wheuer/GeckoSmartWatch/README.md

# Gecko Smart Watch

This repository tracks the most recent state of my personal smart watch project.

It's a mess and unpolished. For a more in depth look at the project and it's history see [my website](https://www.williamfheuer.com/project-portfolio).
