wheuer/GeckoSmartWatch/Docs/images/gecko.png

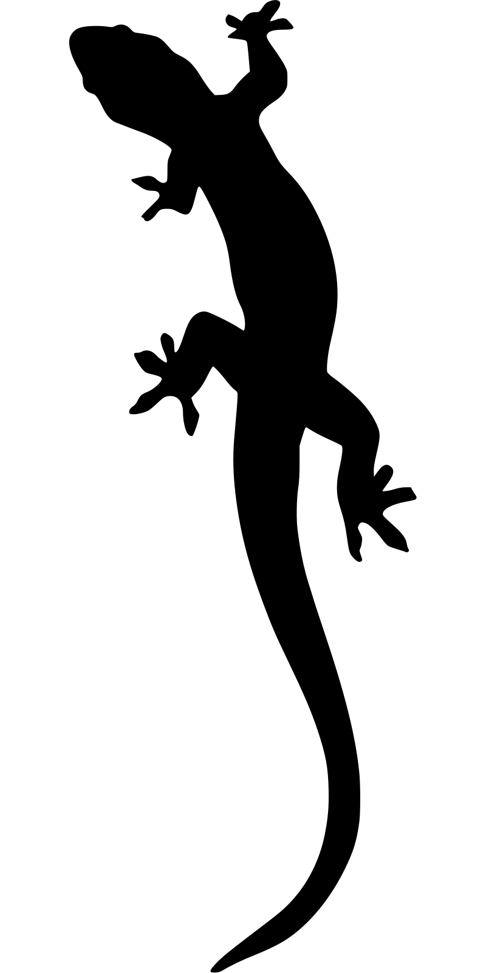
Docs/images/gecko.png
