wheuer/GeckoSmartWatch/Docs/images/Sloth_Tag.png

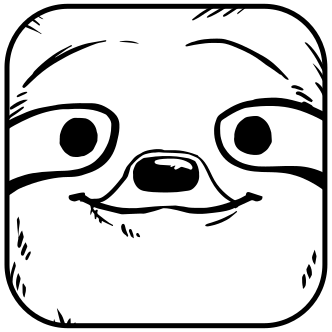
Docs/images/Sloth_Tag.png
