wheuer/GeckoSmartWatch/Software Tools/Display Visualizer/image.png

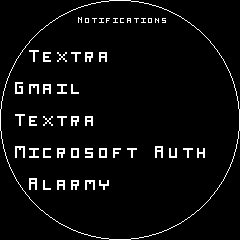
Software Tools/Display Visualizer/image.png
