wheuer/GeckoSmartWatch/KiCad/DevelopmentBoard/GeckoDevelopmentBoard.step

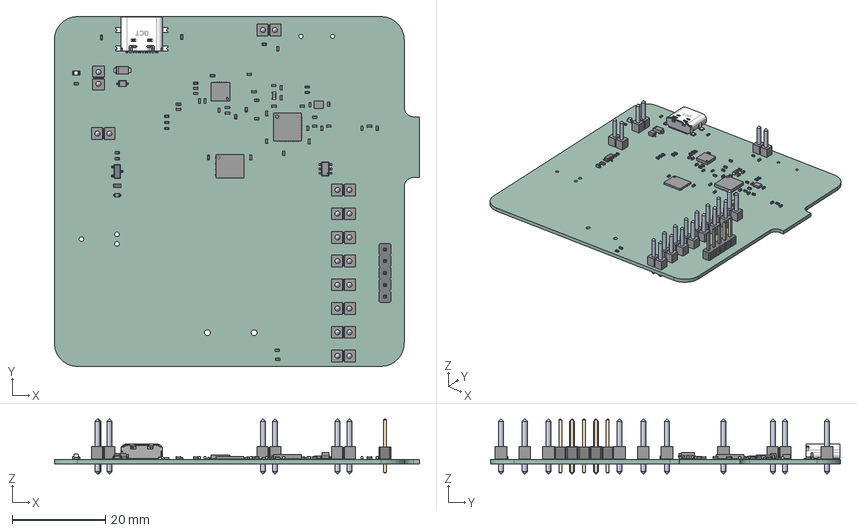
[picture p4: CAD file, 2024-07-24]
KiCad/DevelopmentBoard/GeckoDevelopmentBoard.step
78.3 x 75.0 x 11.7 mm
ASSEMBLY x 19
R_0603_1608Metric
C_0402_1005Metric x 30
SOT_23
LED_0603_1608Metric
PinHeader_1x05_P254mm_Vertical
R_0402_1005Metric x 17
L_0603_1608Metric
USB4110-GF-A
L_0402_1005Metric x 5
GeckoDevelopmentBoard_PCB
