wheuer/GeckoSmartWatch/KiCad/GeckoSmartWatch_V4_1/GeckoSmartWatch_V4_1.step

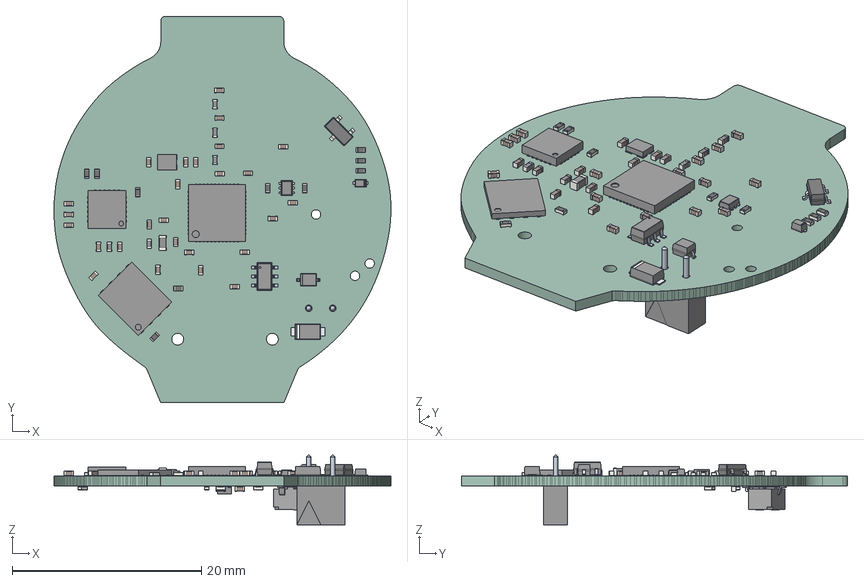
[picture p5: CAD file, 2024-09-02]
KiCad/GeckoSmartWatch_V4_1/GeckoSmartWatch_V4_1.step
35.6 x 40.9 x 7.37 mm
C_0402_1005Metric x 28
R_0402_1005Metric x 15
ASSEMBLY x 9
L_0402_1005Metric x 5
L_0603_1608Metric
DRL0006A_ASM
SOT_23
DSE0006A_ASM
CJS-1200TB
GeckoSmartWatch_V4_1_PCB
