wheuer/GeckoSmartWatch/KiCad/GeckoSmartWatch_V4_1/GeckoSmartWatch_V4_1.kicad_pcb

## KiCad design KiCad/GeckoSmartWatch_V4_1/GeckoSmartWatch_V4_1.kicad_pcb (2024-08-08)

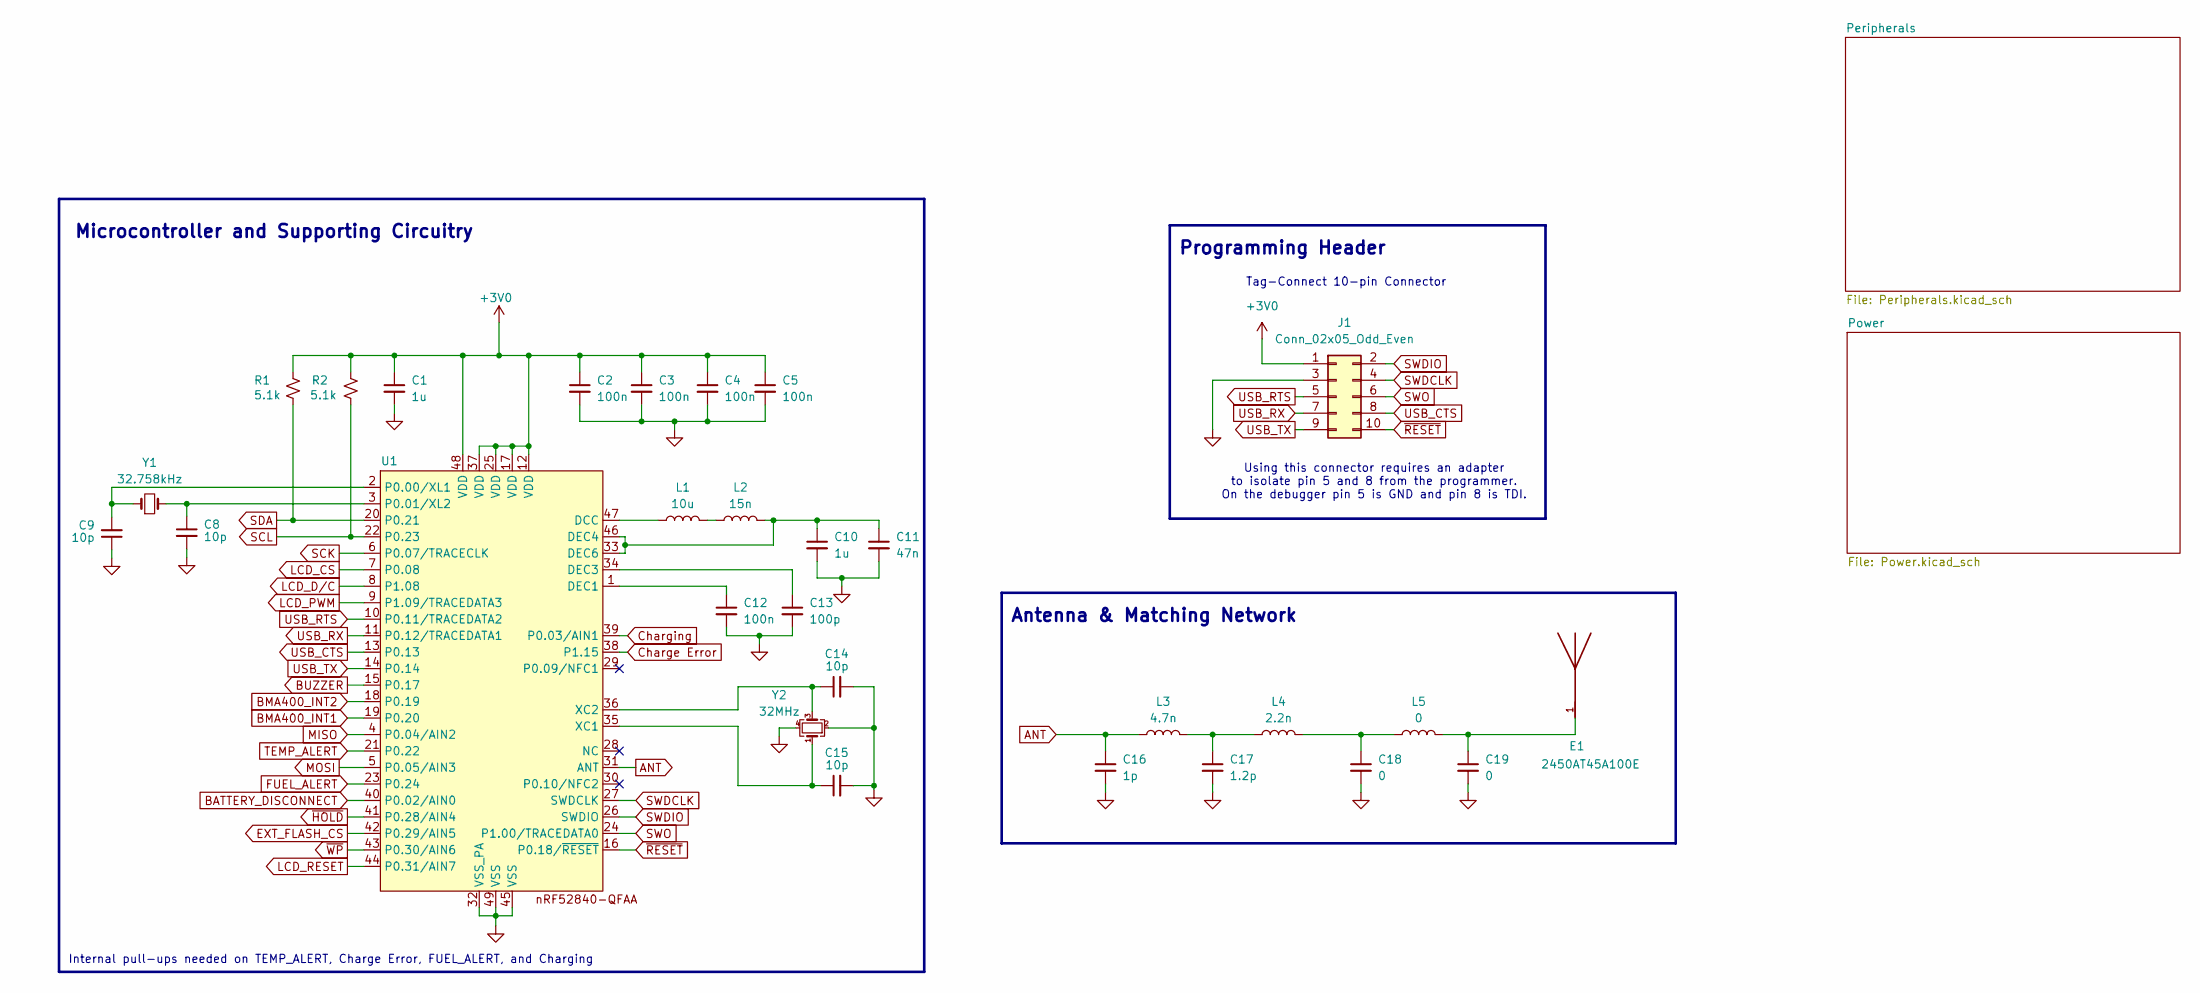
[picture p6: schematic GeckoSmartWatch_V4_1.kicad_sch]

Parts:
C1, C10: 1u; C_0402_1005Metric
C2, C3, C4, C5, C12: 100n; C_0402_1005Metric
C8, C9, C14, C15: 10p; C_0402_1005Metric
C11: 47n; C_0402_1005Metric
C13: 100p; C_0402_1005Metric
C16: 1p; C_0402_1005Metric
C17: 1.2p; C_0402_1005Metric
C18, C19: 0; C_0402_1005Metric
E1: 2450AT45A100E; ANT_2450AT45A100E; PARTREV 3.1
J1: Conn_02x05_Odd_Even; TAG-CONNECT_TC2050-IDC-NL
L1: 10u; L_0603_1608Metric
L2: 15n; L_0402_1005Metric
L3: 4.7n; L_0402_1005Metric
L4: 2.2n; L_0402_1005Metric
L5: 0; L_0402_1005Metric
R1, R2: 5.1k; R_0402_1005Metric
U1: nrf52840_QFN40P600X600X95-49N-D
Y1: 32.758kHz; 32kHz_ECS32712512RCTR
Y2: 32MHz; 32MHz_ECS320837CKMTR3

Connections:
+3V0: C1.1, C2.1, C3.1, C4.1, C5.1, J1.1, R1.2, R2.2, U1.12 (VDD), U1.17 (VDD), U1.25 (VDD), U1.37 (VDD), U1.48 (VDD); also elsewhere on the board
ANT: C16.1, L3.1, U1.31 (ANT)
BATTERY_DISCONNECT: U1.40 (P0.02/AIN0); also elsewhere on the board
BMA400_INT1: U1.19 (P0.20); also elsewhere on the board
BMA400_INT2: U1.18 (P0.19); also elsewhere on the board
BUZZER: U1.15 (P0.17); also elsewhere on the board
Charge Error: U1.38 (P1.15); also elsewhere on the board
Charging: U1.39 (P0.03/AIN1); also elsewhere on the board
EXT_FLASH_CS: U1.42 (P0.29/AIN5); also elsewhere on the board
FUEL_ALERT: U1.23 (P0.24); also elsewhere on the board
GND: C1.2, C2.2, C3.2, C4.2, C5.2, C8.2, C9.1, C10.2, C11.2, C12.2, C13.2, C14.2, C15.2, C16.2, C17.2, C18.2, C19.2, J1.3, U1.32 (VSS_PA), U1.45 (VSS), U1.49 (VSS), Y2.2, Y2.4; also elsewhere on the board
LCD_CS: U1.7 (P0.08); also elsewhere on the board
LCD_D/C: U1.8 (P1.08); also elsewhere on the board
LCD_PWM: U1.9 (P1.09/TRACEDATA3); also elsewhere on the board
LCD_RESET: U1.44 (P0.31/AIN7); also elsewhere on the board
MISO: U1.4 (P0.04/AIN2); also elsewhere on the board
MOSI: U1.5 (P0.05/AIN3); also elsewhere on the board
unnamed: C17.1, L3.2, L4.1
unnamed: C18.1, L4.2, L5.1
unnamed: C19.1, E1.1, L5.2
unnamed: L1.2, L2.1
unnamed: L1.1, U1.47 (DCC)
unnamed: C12.1, U1.1 (DEC1)
unnamed: C13.1, U1.34 (DEC3)
unnamed: C10.1, C11.1, L2.2, U1.33 (DEC6), U1.46 (DEC4)
unnamed: C9.2, U1.2 (P0.00/XL1), Y1.1
unnamed: C8.1, U1.3 (P0.01/XL2), Y1.2
unnamed: C15.1, U1.35 (XC1), Y2.1
unnamed: C14.1, U1.36 (XC2), Y2.3
SCK: U1.6 (P0.07/TRACECLK); also elsewhere on the board
SCL: R2.1, U1.22 (P0.23); also elsewhere on the board
SDA: R1.1, U1.20 (P0.21); also elsewhere on the board
SWDCLK: J1.4, U1.27 (SWDCLK)
SWDIO: J1.2, U1.26 (SWDIO)
SWO: J1.6, U1.24 (P1.00/TRACEDATA0)
TEMP_ALERT: U1.21 (P0.22); also elsewhere on the board
USB_CTS: J1.8, U1.13 (P0.13)
USB_RTS: J1.5, U1.10 (P0.11/TRACEDATA2)
USB_RX: J1.7, U1.11 (P0.12/TRACEDATA1)
USB_TX: J1.9, U1.14 (P0.14)
~HOLD: U1.41 (P0.28/AIN4); also elsewhere on the board
~RESET: J1.10, U1.16 (P0.18/~RESET)
~WP: U1.43 (P0.30/AIN6); also elsewhere on the board

Notes on the sheet:
Antenna & Matching Network
Using this connector requires an adapter to isolate pin 5 and 8 from the programmer. On the debugger pin 5 is GND and pin 8 is TDI.
Internal pull-ups needed on TEMP_ALERT, Charge Error, FUEL_ALERT, and Charging
Tag-Connect 10-pin Connector
Programming Header
Microcontroller and Supporting Circuitry

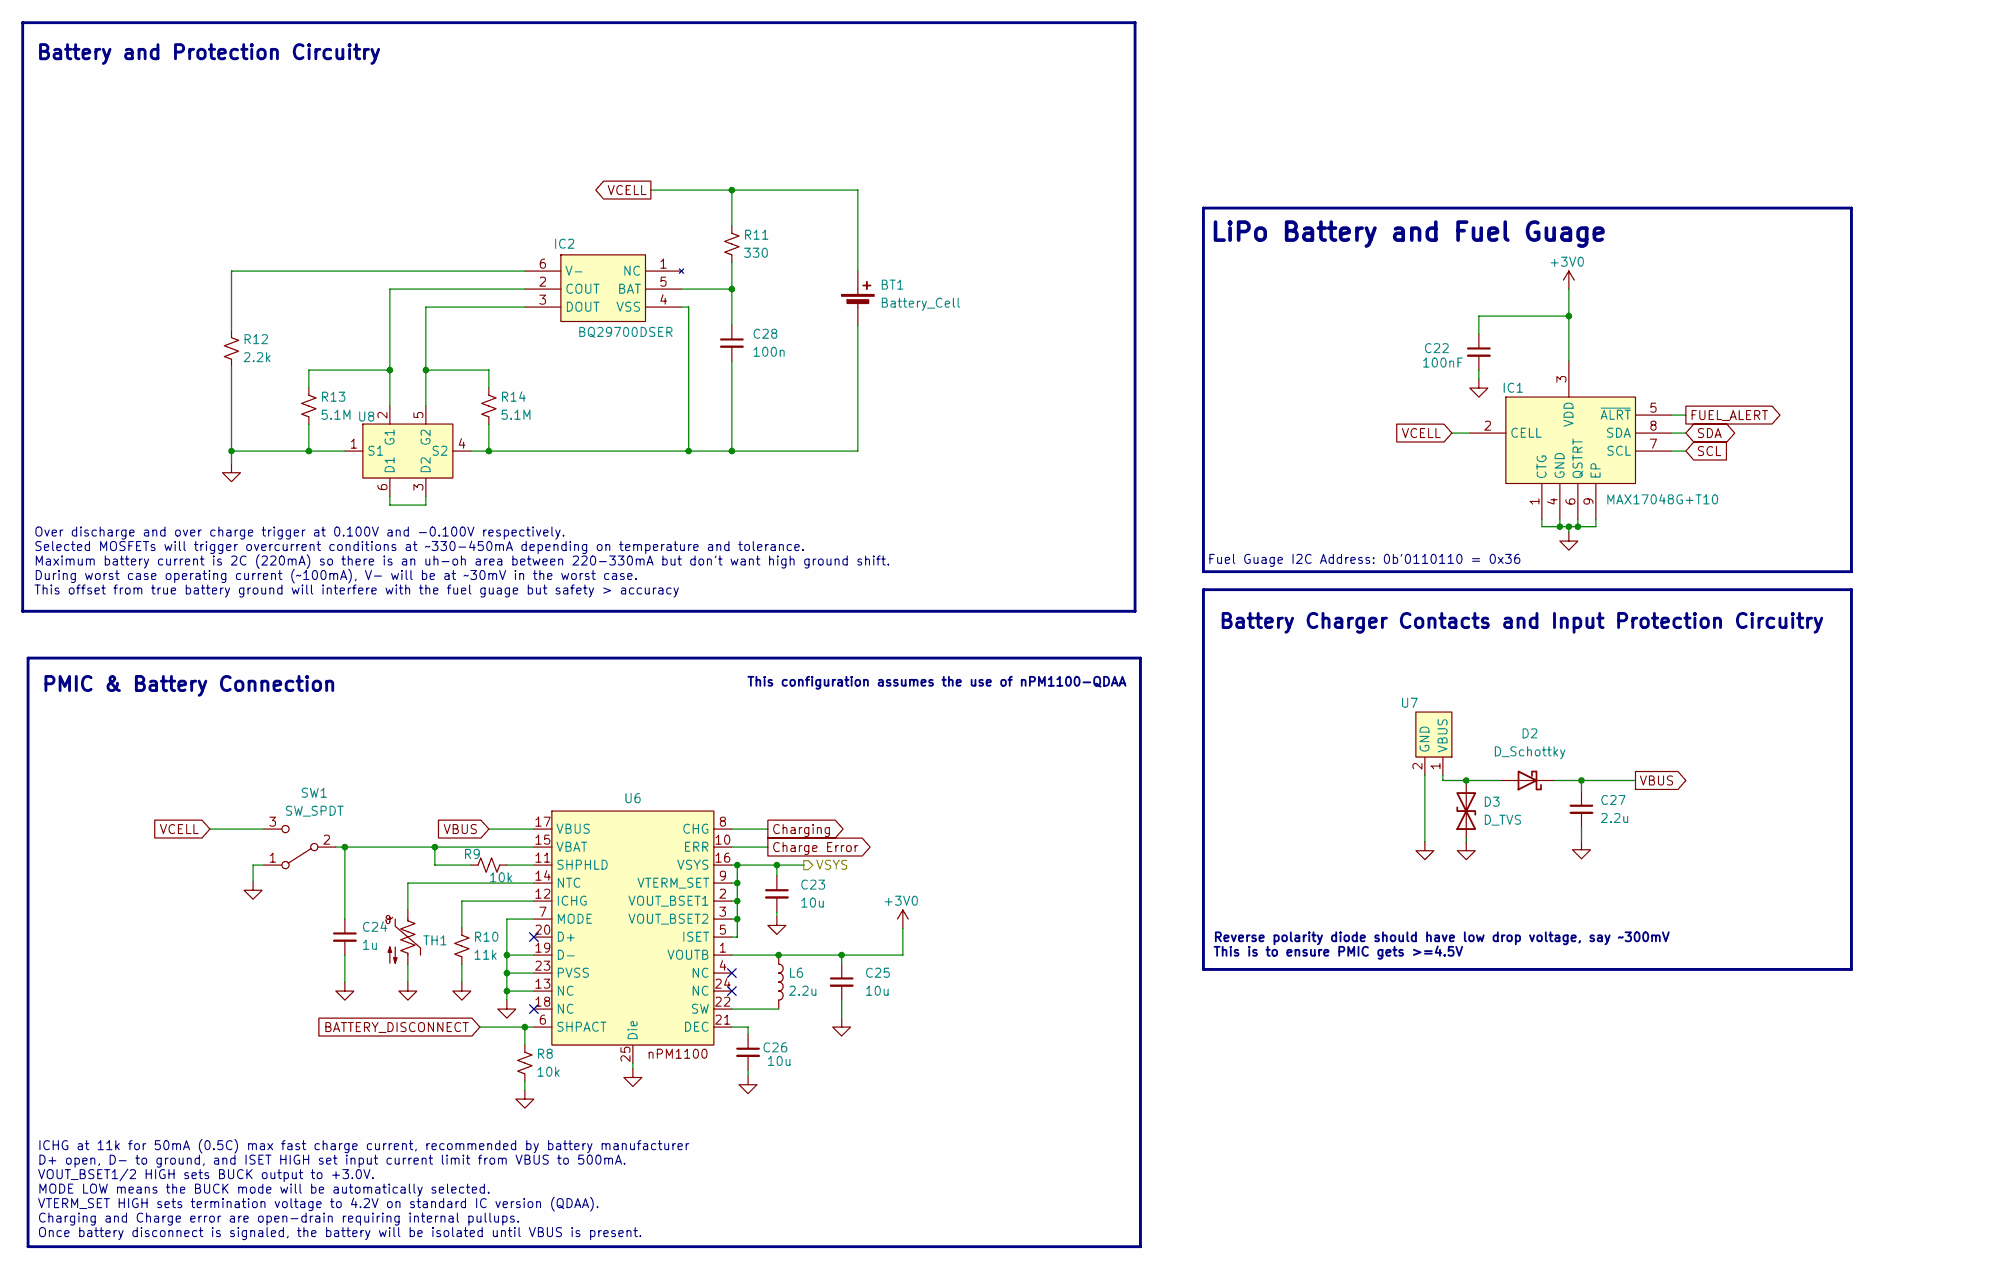
[picture p7: schematic Power.kicad_sch]

Parts:
BT1: Battery_Cell; RJD2430C1ST1
C22: 100nF; C_0402_1005Metric
C23, C25, C26: 10u; C_0402_1005Metric
C24: 1u; C_0402_1005Metric
C27: 2.2u; C_0402_1005Metric
C28: 100n; C_0402_1005Metric
D2: D_Schottky; reversePolarity_SODFL3616X98N
D3: D_TVS; TVS_SOD2513X120N
IC1: MAX17048G+T10; MAX17048_fuelGuague; Mouser Part Number 700-MAX17048G+T10
IC2: BQ29700DSER; batProtect_SON50P150X150X80-6N; Mouser Part Number 595-BQ29700DSER
L6: 2.2u; L_0402_1005Metric
R8, R9: 10k; R_0402_1005Metric
R10: 11k; R_0402_1005Metric
R11: 330; R_0402_1005Metric
R12: 2.2k; R_0402_1005Metric
R13, R14: 5.1M; R_0402_1005Metric
SW1: SW_SPDT; pwrSW_B-TYPE
TH1: Thermistor_NTC_US; R_0402_1005Metric
U6: nPM1100_QFN50P400X400X90-25N-D
U7: chargeContacts_RHDR2W51P0X254_1X2_508X254X419P
U8: batMOS_SOTFL95P280X88-6N

Connections:
+3V0: C22.1, C25.1, IC1.3 (VDD), L6.1, U6.1 (VOUTB); also elsewhere on the board
/Power/VSYS: C23.1, U6.2 (VOUT_BSET1), U6.3 (VOUT_BSET2), U6.5 (ISET), U6.9 (VTERM_SET), U6.16 (VSYS)
BATTERY_DISCONNECT: R8.1, U6.6 (SHPACT); also elsewhere on the board
Charge Error: U6.10 (ERR); also elsewhere on the board
Charging: U6.8 (CHG); also elsewhere on the board
FUEL_ALERT: IC1.5 (~ALRT); also elsewhere on the board
GND: C22.2, C23.2, C24.2, C25.2, C26.2, C27.2, D3.1 (A1), IC1.1 (CTG), IC1.4 (GND), IC1.6 (QSTRT), IC1.9 (EP), R8.2, R10.2, R12.2, R13.2, SW1.1 (A), TH1.2, U6.7 (MODE), U6.13 (NC), U6.19 (D-), U6.23 (PVSS), U6.25 (Die), U7.2 (GND), U8.1 (S1); also elsewhere on the board
unnamed: BT1.2 (-), C28.2, IC2.4 (VSS), R14.2, U8.4 (S2)
unnamed: D2.2 (A), D3.2 (A2), U7.1 (VBUS)
unnamed: C28.1, IC2.5 (BAT), R11.2
unnamed: IC2.2 (COUT), R13.1, U8.2 (G1)
unnamed: IC2.3 (DOUT), R14.1, U8.5 (G2)
unnamed: IC2.6 (V-), R12.1
unnamed: C24.1, R9.1, SW1.2 (B), U6.15 (VBAT)
unnamed: C26.1, U6.21 (DEC)
unnamed: R10.1, U6.12 (ICHG)
unnamed: TH1.1, U6.14 (NTC)
unnamed: R9.2, U6.11 (SHPHLD)
unnamed: L6.2, U6.22 (SW)
unnamed: U8.3 (D2), U8.6 (D1)
SCL: IC1.7 (SCL); also elsewhere on the board
SDA: IC1.8 (SDA); also elsewhere on the board
VBUS: C27.1, D2.1 (K), U6.17 (VBUS)
VCELL: BT1.1 (+), IC1.2 (CELL), R11.1, SW1.3 (C)

Notes on the sheet:
Battery and Protection Circuitry
Reverse polarity diode should have low drop voltage, say ~300mV This is to ensure PMIC gets >=4.5V
Over discharge and over charge trigger at 0.100V and -0.100V respectively. Selected MOSFETs will trigger overcurrent conditions at ~330-450mA depending on temperature and tolerance. Maximum battery current is 2C (220mA) so there is an uh-oh area between 220-330mA but don't want high ground shift. D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
This configuration assumes the use of nPM1100-QDAA
Battery Charger Contacts and Input Protection Circuitry
LiPo Battery and Fuel Guage
Fuel Guage I2C Address: 0b'0110110 = 0x36
PMIC & Battery Connection
ICHG at 11k for 50mA (0.5C) max fast charge current, recommended by battery manufacturer D+ open, D- to ground, and ISET HIGH set input current limit from VBUS to 500mA. VOUT_BSET1/2 HIGH sets BUCK output to +3.0V. MODE LOW means the BUCK mode will be automatically selected. VTERM_SET HIGH sets ter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

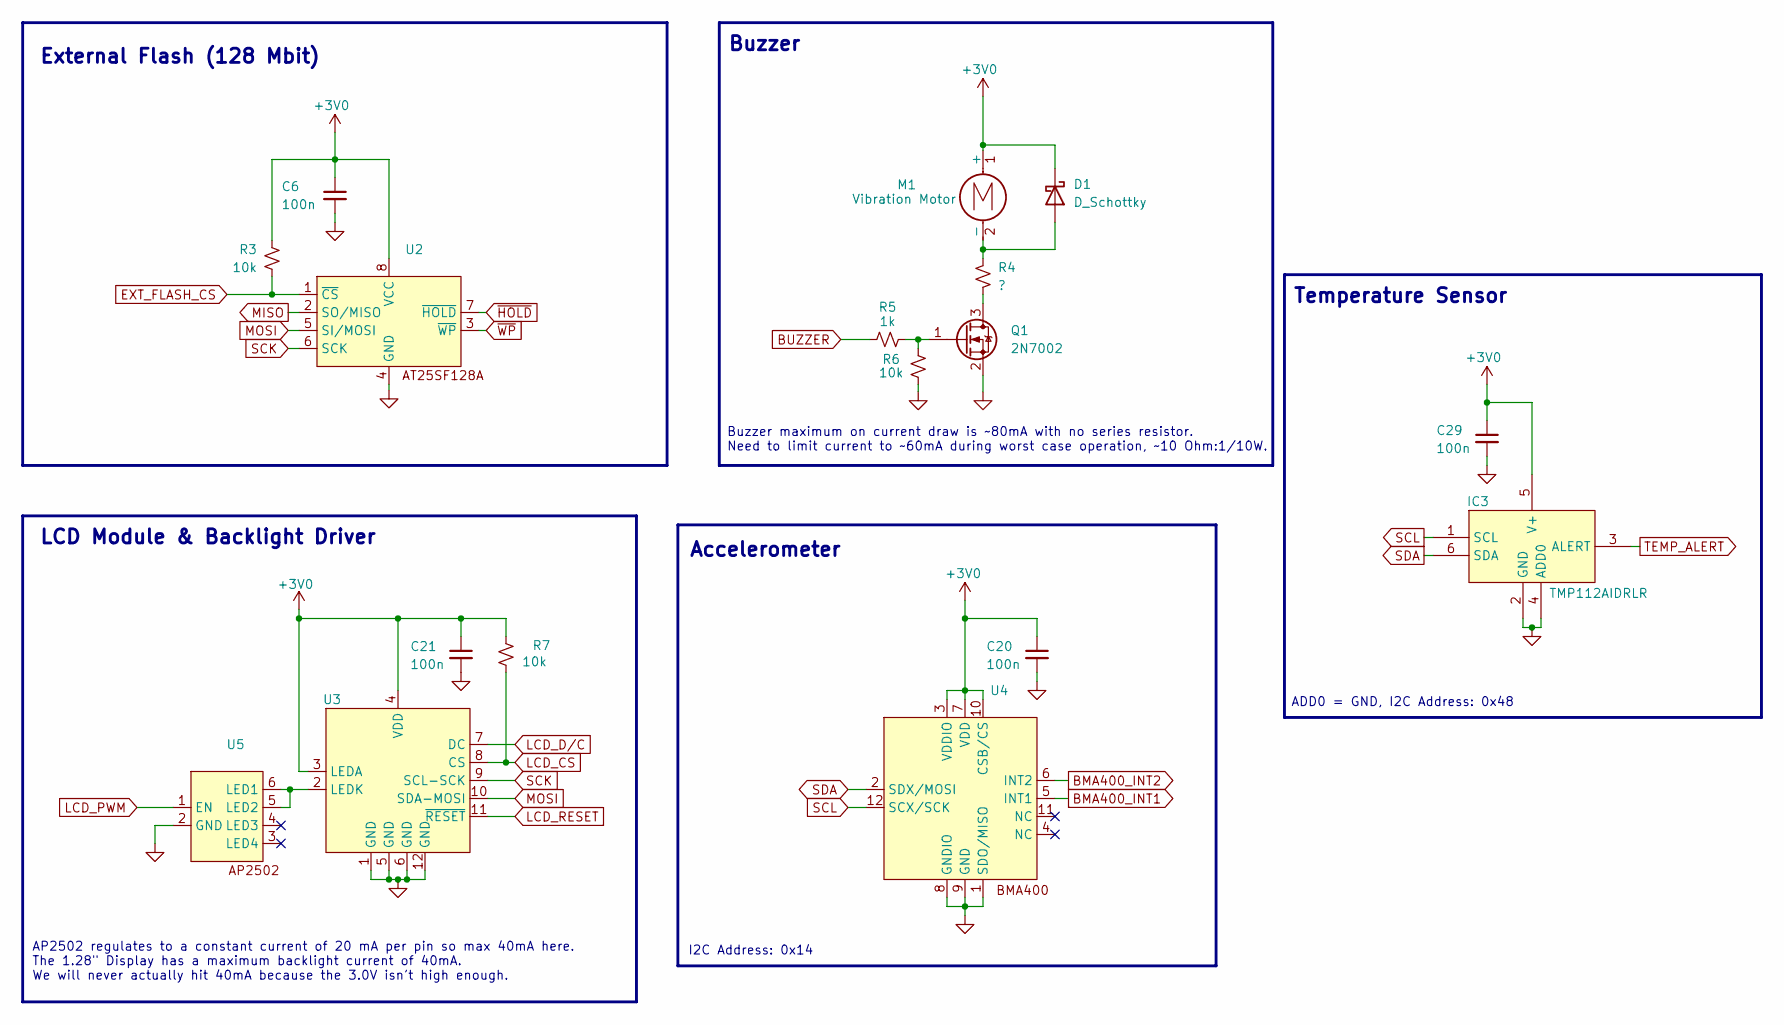
[picture p8: schematic Peripherals.kicad_sch]

Parts:
C6, C20, C21, C29: 100n; C_0402_1005Metric
D1: D_Schottky; flyback_SODFL1608X70N
IC3: TMP112AIDRLR; tmp_SOTFL50P160X60-6N; Mouser Part Number 595-TMP112AIDRLR
M1: Vibration Motor; SMD_vibrationMotor
Q1: 2N7002; SOT-23
R3, R6, R7: 10k; R_0402_1005Metric
R4: ?; R_0402_1005Metric
R5: 1k; R_0402_1005Metric
U2: extFlash_SON127P600X500X60-9N-D
U3: 1.47_TFT_displayConnector
U4: BOSCH_LGA_12
U5: AP2502_SOT95P280X145-6N

Connections:
+3V0: C6.1, C20.1, C21.1, C29.1, D1.1 (K), IC3.5 (V+), M1.1 (+), R3.1, R7.1, U2.8 (VCC), U3.3 (LEDA), U3.4 (VDD), U4.3 (VDDIO), U4.7 (VDD), U4.10 (CSB/CS); also elsewhere on the board
BMA400_INT1: U4.5 (INT1); also elsewhere on the board
BMA400_INT2: U4.6 (INT2); also elsewhere on the board
BUZZER: R5.1; also elsewhere on the board
EXT_FLASH_CS: R3.2, U2.1 (~CS); also elsewhere on the board
GND: C6.2, C20.2, C21.2, C29.2, IC3.2 (GND), IC3.4 (ADD0), Q1.2 (S), R6.1, U2.4 (GND), U3.1 (GND), U3.5 (GND), U3.6 (GND), U3.12 (GND), U4.1 (SDO/MISO), U4.8 (GNDIO), U4.9 (GND), U5.2 (GND); also elsewhere on the board
LCD_CS: R7.2, U3.8 (CS); also elsewhere on the board
LCD_D/C: U3.7 (DC); also elsewhere on the board
LCD_PWM: U5.1 (EN); also elsewhere on the board
LCD_RESET: U3.11 (~RESET); also elsewhere on the board
MISO: U2.2 (SO/MISO); also elsewhere on the board
MOSI: U2.5 (SI/MOSI), U3.10 (SDA-MOSI); also elsewhere on the board
unnamed: D1.2 (A), M1.2 (-), R4.1
unnamed: Q1.3 (D), R4.2
unnamed: Q1.1 (G), R5.2, R6.2
unnamed: U3.2 (LEDK), U5.5 (LED2), U5.6 (LED1)
SCK: U2.6 (SCK), U3.9 (SCL-SCK); also elsewhere on the board
SCL: IC3.1 (SCL), U4.12 (SCX/SCK); also elsewhere on the board
SDA: IC3.6 (SDA), U4.2 (SDX/MOSI); also elsewhere on the board
TEMP_ALERT: IC3.3 (ALERT); also elsewhere on the board
~HOLD: U2.7 (~HOLD); also elsewhere on the board
~WP: U2.3 (~WP); also elsewhere on the board

Notes on the sheet:
Buzzer
I2C Address: 0x14
ADD0 = GND, I2C Address: 0x48
AP2502 regulates to a constant current of 20 mA per pin so max 40mA here. The 1.28" Display has a maximum backlight current of 40mA. We will never actually hit 40mA because the 3.0V isn't high enough.
Buzzer maximum on current draw is ~80mA with no series resistor. Need to limit current to ~60mA during worst case operation, ~10 Ohm:1/10W.
Temperature Sensor
External Flash (128 Mbit)
LCD Module & Backlight Driver
Accelerometer

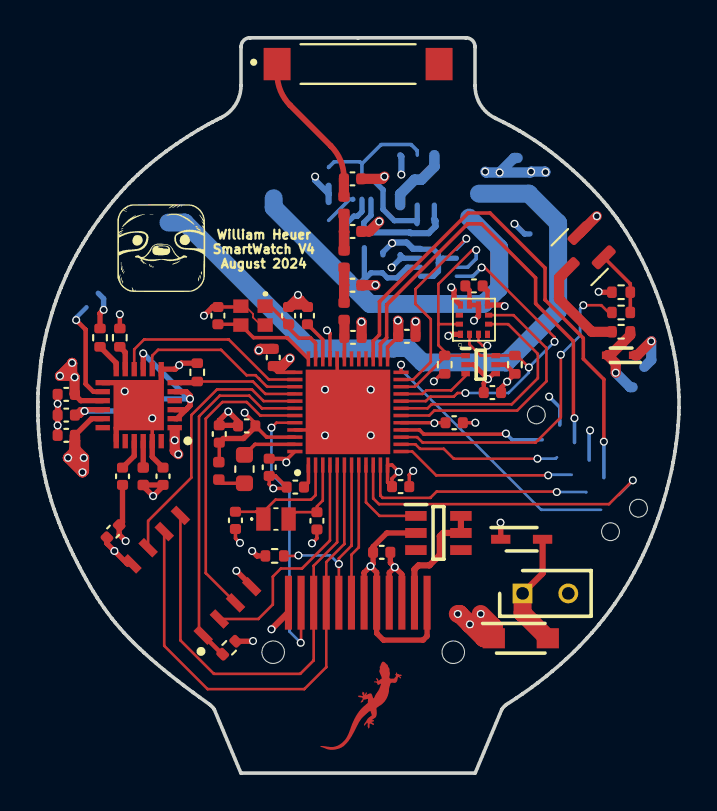
[picture p9: board GeckoSmartWatch_V4_1.kicad_pcb from above]

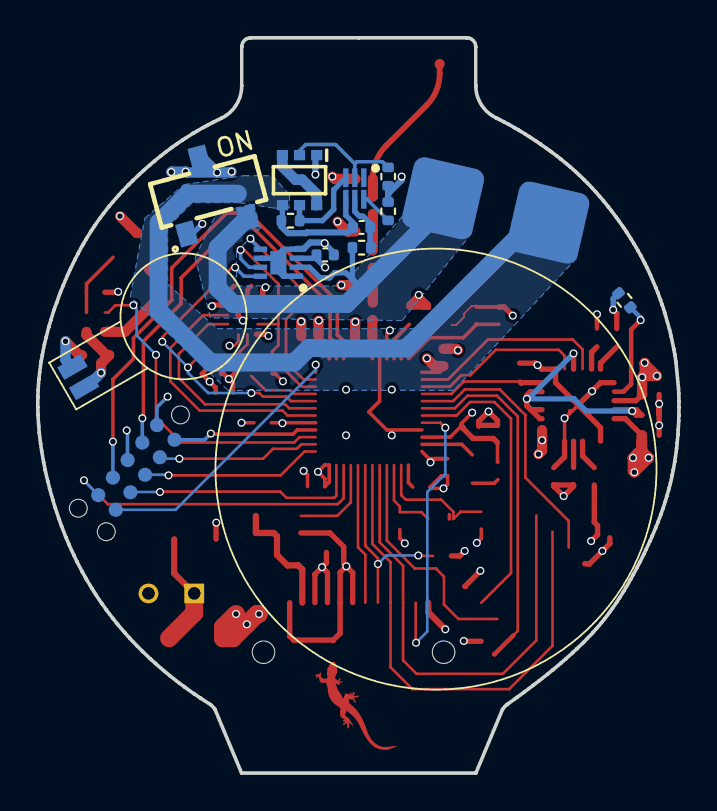
[picture p10: board GeckoSmartWatch_V4_1.kicad_pcb from below]

Board: 4 copper layers, 35.6 x 40.9 mm, 71 parts (14 on the bottom side), 63 nets.
