wheuer/GeckoSmartWatch/KiCad/TagConnectAdapter/TagConnectAdapter.kicad_pcb

## KiCad design KiCad/TagConnectAdapter/TagConnectAdapter.kicad_pcb (2024-07-24)

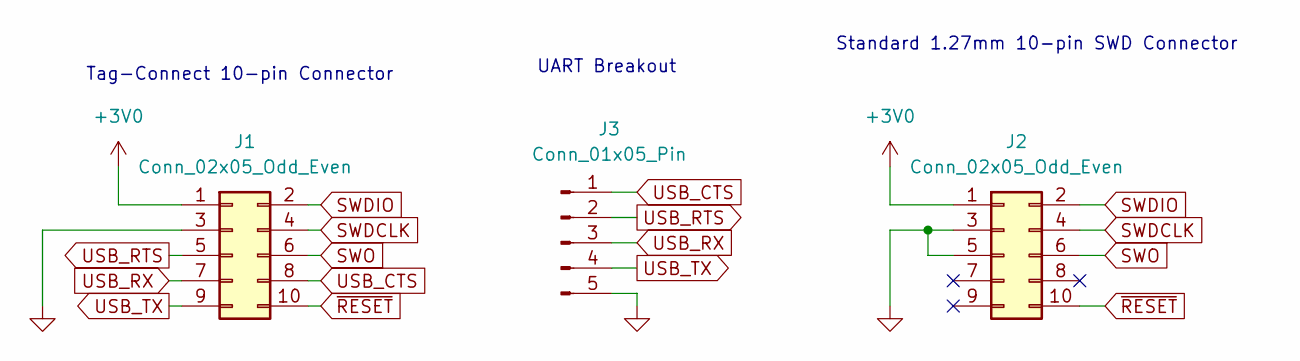
[picture p11: schematic TagConnectAdapter.kicad_sch]

Parts:
J1: Conn_02x05_Odd_Even; CNC_TECH_1.27mm_10-pin
J2: Conn_02x05_Odd_Even; AMPHENOL_20021311-00010T4LF
J3: Conn_01x05_Pin; PinSocket_1x05_P2.54mm_Vertical

Connections:
+3V0: J1.1, J2.1
GND: J1.3, J2.3, J2.5, J3.5
SWDCLK: J1.4, J2.4
SWDIO: J1.2, J2.2
SWO: J1.6, J2.6
USB_CTS: J1.8, J3.1
USB_RTS: J1.5, J3.2
USB_RX: J1.7, J3.3
USB_TX: J1.9, J3.4
~RESET: J1.10, J2.10

Notes on the sheet:
Standard 1.27mm 10-pin SWD Connector
UART Breakout
Tag-Connect 10-pin Connector

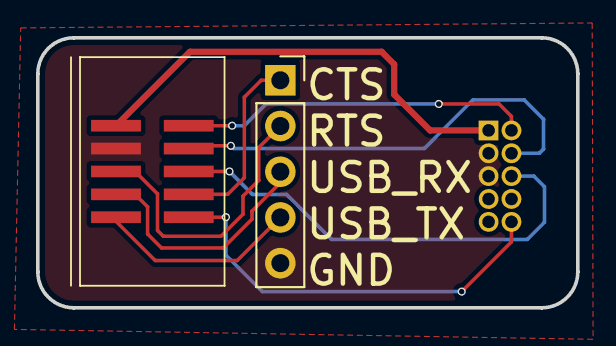
[picture p12: board TagConnectAdapter.kicad_pcb from above]

Board: 2 copper layers, 30.0 x 15.0 mm, 3 parts (1 on the bottom side), 10 nets.
