wheuer/GeckoSmartWatch/KiCad/DevelopmentBoard/GeckoDevelopmentBoard.kicad_pcb

## KiCad design KiCad/DevelopmentBoard/GeckoDevelopmentBoard.kicad_pcb (2024-07-24)

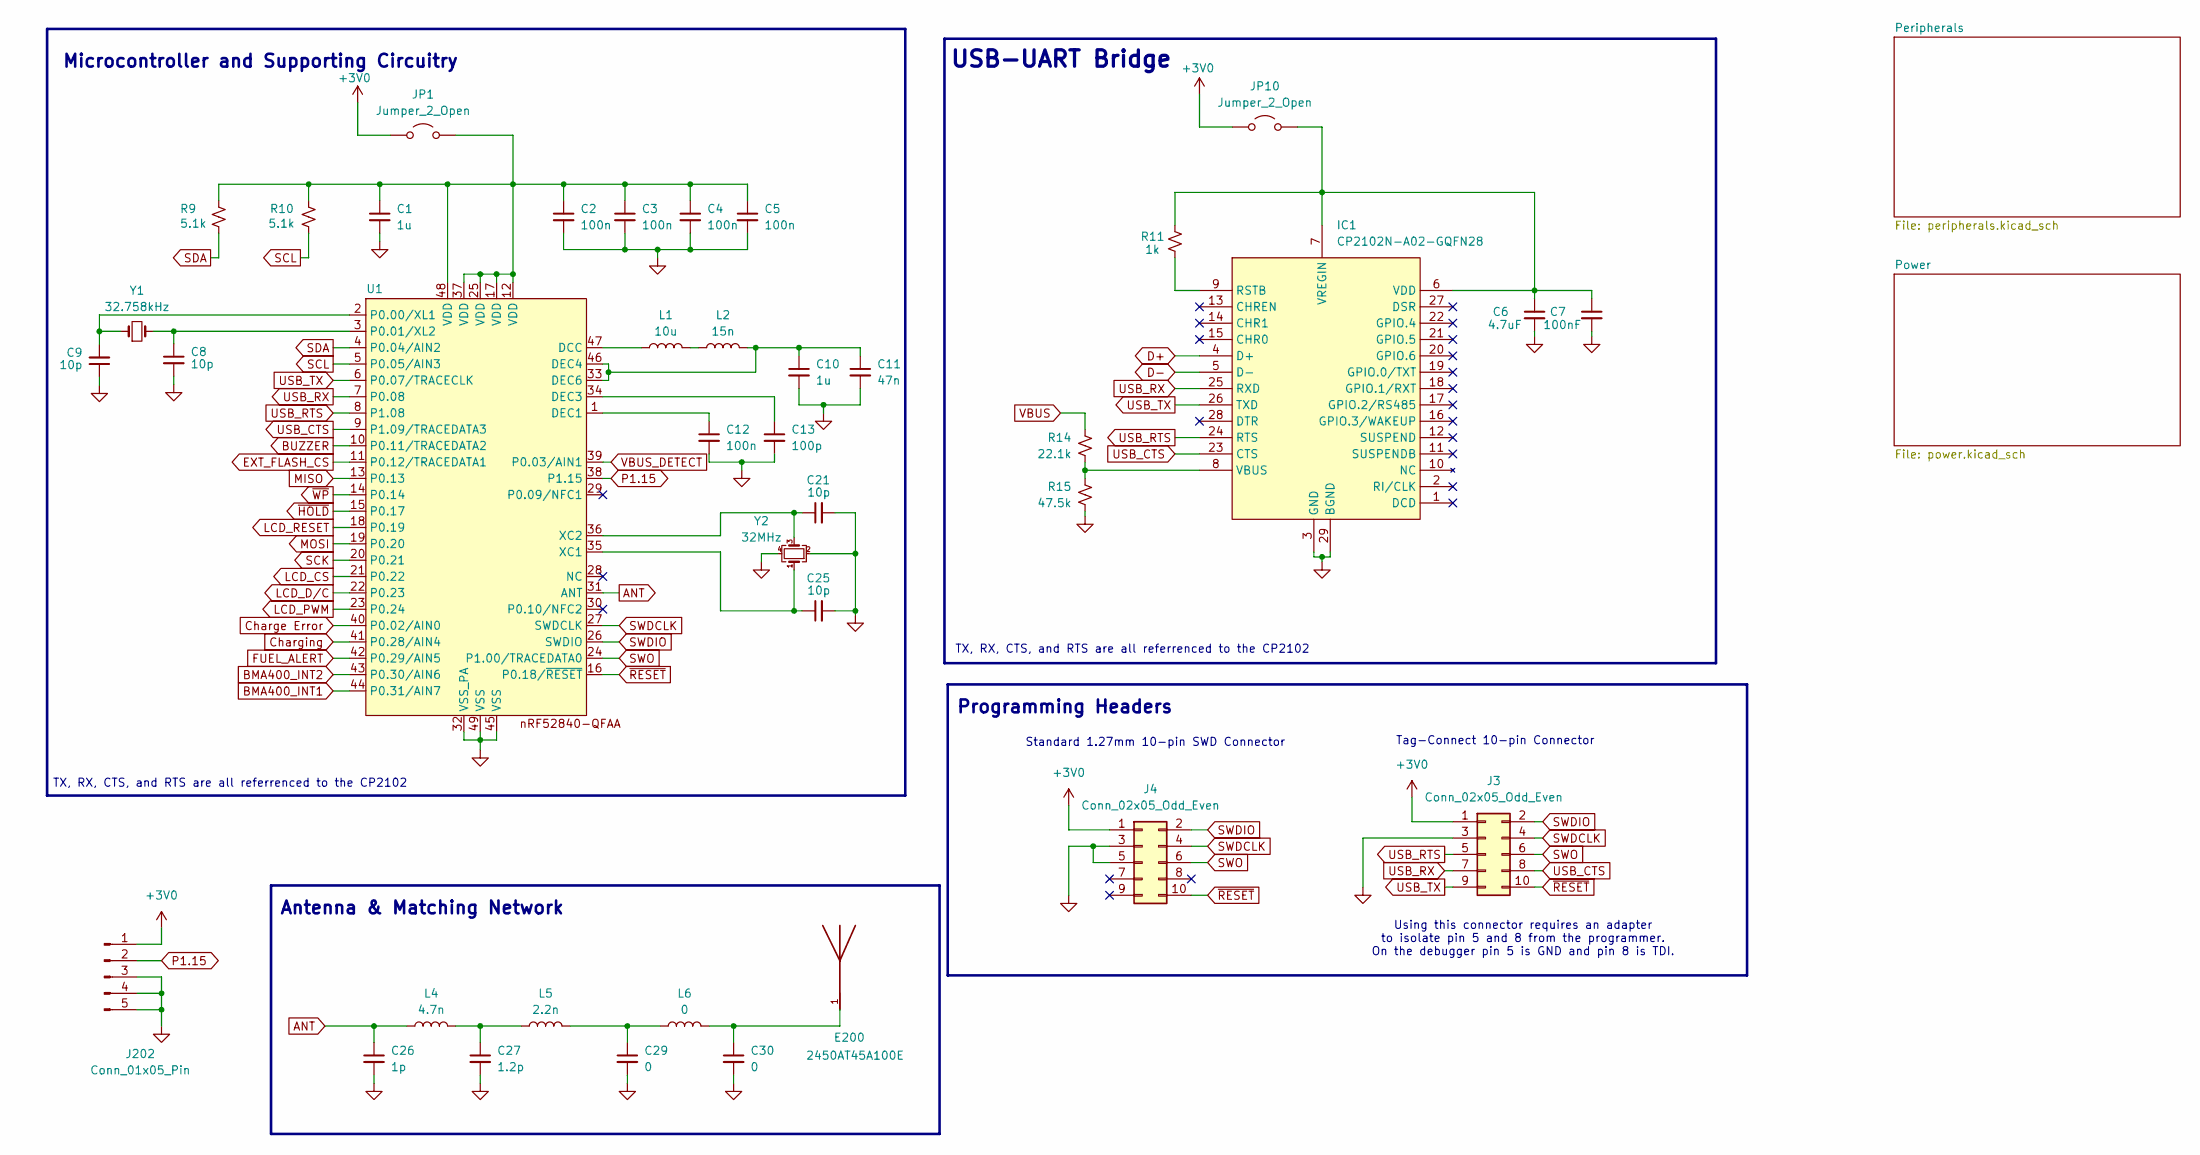
[picture p13: schematic GeckoDevelopmentBoard.kicad_sch]

Parts:
C1, C10: 1u; C_0402_1005Metric
C2, C3, C4, C5, C12: 100n; C_0402_1005Metric
C6: 4.7uF; C_0402_1005Metric
C7: 100nF; C_0402_1005Metric
C8, C9, C21, C25: 10p; C_0402_1005Metric
C11: 47n; C_0402_1005Metric
C13: 100p; C_0402_1005Metric
C26: 1p; C_0402_1005Metric
C27: 1.2p; C_0402_1005Metric
C29, C30: 0; C_0402_1005Metric
E200: 2450AT45A100E; ANT_2450AT45A100E; PARTREV 3.1
IC1: CP2102N-A02-GQFN28; CP2102_5x5QFN; Mouser Part Number 634-CP2102NA02GQFN28
J3: Conn_02x05_Odd_Even; TAG-CONNECT_TC2050-IDC-NL
J4: Conn_02x05_Odd_Even; CNC_TECH_1.27mm_10-pin
J202: Conn_01x05_Pin; PinHeader_1x05_P2.54mm_Vertical
JP1, JP10: Jumper_2_Open; 2pinJumper_HDRV2W110P0X254_1X2_508X254X854P
L1: 10u; L_0603_1608Metric
L2: 15n; L_0402_1005Metric
L4: 4.7n; L_0402_1005Metric
L5: 2.2n; L_0402_1005Metric
L6: 0; L_0402_1005Metric
R9, R10: 5.1k; R_0402_1005Metric
R11: 1k; R_0402_1005Metric
R14: 22.1k; R_0402_1005Metric
R15: 47.5k; R_0402_1005Metric
U1: nrf52840_QFN40P600X600X95-49N-D
Y1: 32.758kHz; 32kHz_ECS32712512RCTR
Y2: 32MHz; 32MHz_ECS320837CKMTR3

Connections:
+3V0: J3.1, J4.1, J202.1, JP1.1 (A), JP10.1 (A); also elsewhere on the board
ANT: C26.1, L4.1, U1.31 (ANT)
BMA400_INT1: U1.44 (P0.31/AIN7); also elsewhere on the board
BMA400_INT2: U1.43 (P0.30/AIN6); also elsewhere on the board
BUZZER: U1.10 (P0.11/TRACEDATA2); also elsewhere on the board
Charge Error: U1.40 (P0.02/AIN0); also elsewhere on the board
Charging: U1.41 (P0.28/AIN4); also elsewhere on the board
D+: IC1.4 (D+); also elsewhere on the board
D-: IC1.5 (D-); also elsewhere on the board
EXT_FLASH_CS: U1.11 (P0.12/TRACEDATA1); also elsewhere on the board
FUEL_ALERT: U1.42 (P0.29/AIN5); also elsewhere on the board
GND: C1.2, C2.2, C3.2, C4.2, C5.2, C6.2, C7.2, C8.2, C9.1, C10.2, C11.2, C12.2, C13.2, C21.2, C25.2, C26.2, C27.2, C29.2, C30.2, IC1.3 (GND), IC1.29 (BGND), J3.3, J4.3, J4.5, J202.3, J202.4, J202.5, R15.2, U1.32 (VSS_PA), U1.45 (VSS), U1.49 (VSS), Y2.2, Y2.4; also elsewhere on the board
LCD_CS: U1.21 (P0.22); also elsewhere on the board
LCD_D/C: U1.22 (P0.23); also elsewhere on the board
LCD_PWM: U1.23 (P0.24); also elsewhere on the board
LCD_RESET: U1.18 (P0.19); also elsewhere on the board
MISO: U1.13 (P0.13); also elsewhere on the board
MOSI: U1.19 (P0.20); also elsewhere on the board
unnamed: C27.1, L4.2, L5.1
unnamed: C29.1, L5.2, L6.1
unnamed: C30.1, E200.1, L6.2
unnamed: IC1.9 (RSTB), R11.2
unnamed: IC1.8 (VBUS), R14.2, R15.1
unnamed: C6.1, C7.1, IC1.6 (VDD), IC1.7 (VREGIN), JP10.2 (B), R11.1
unnamed: C1.1, C2.1, C3.1, C4.1, C5.1, JP1.2 (B), R9.2, R10.2, U1.12 (VDD), U1.17 (VDD), U1.25 (VDD), U1.37 (VDD), U1.48 (VDD)
unnamed: L1.2, L2.1
unnamed: L1.1, U1.47 (DCC)
unnamed: C12.1, U1.1 (DEC1)
unnamed: C13.1, U1.34 (DEC3)
unnamed: C10.1, C11.1, L2.2, U1.33 (DEC6), U1.46 (DEC4)
unnamed: C9.2, U1.2 (P0.00/XL1), Y1.1
unnamed: C8.1, U1.3 (P0.01/XL2), Y1.2
unnamed: C25.1, U1.35 (XC1), Y2.1
unnamed: C21.1, U1.36 (XC2), Y2.3
P1.15: J202.2, U1.38 (P1.15)
SCK: U1.20 (P0.21); also elsewhere on the board
SCL: R10.1, U1.5 (P0.05/AIN3); also elsewhere on the board
SDA: R9.1, U1.4 (P0.04/AIN2); also elsewhere on the board
SWDCLK: J3.4, J4.4, U1.27 (SWDCLK)
SWDIO: J3.2, J4.2, U1.26 (SWDIO)
SWO: J3.6, J4.6, U1.24 (P1.00/TRACEDATA0)
USB_CTS: IC1.23 (CTS), J3.8, U1.9 (P1.09/TRACEDATA3)
USB_RTS: IC1.24 (RTS), J3.5, U1.8 (P1.08)
USB_RX: IC1.25 (RXD), J3.7, U1.7 (P0.08)
USB_TX: IC1.26 (TXD), J3.9, U1.6 (P0.07/TRACECLK)
VBUS: R14.1; also elsewhere on the board
VBUS_DETECT: U1.39 (P0.03/AIN1); also elsewhere on the board
~HOLD: U1.15 (P0.17); also elsewhere on the board
~RESET: J3.10, J4.10, U1.16 (P0.18/~RESET)
~WP: U1.14 (P0.14); also elsewhere on the board

Notes on the sheet:
USB-UART Bridge
TX, RX, CTS, and RTS are all referrenced to the CP2102
Tag-Connect 10-pin Connector
Antenna & Matching Network
Programming Headers
Standard 1.27mm 10-pin SWD Connector
Microcontroller and Supporting Circuitry
Using this connector requires an adapter to isolate pin 5 and 8 from the programmer. On the debugger pin 5 is GND and pin 8 is TDI.

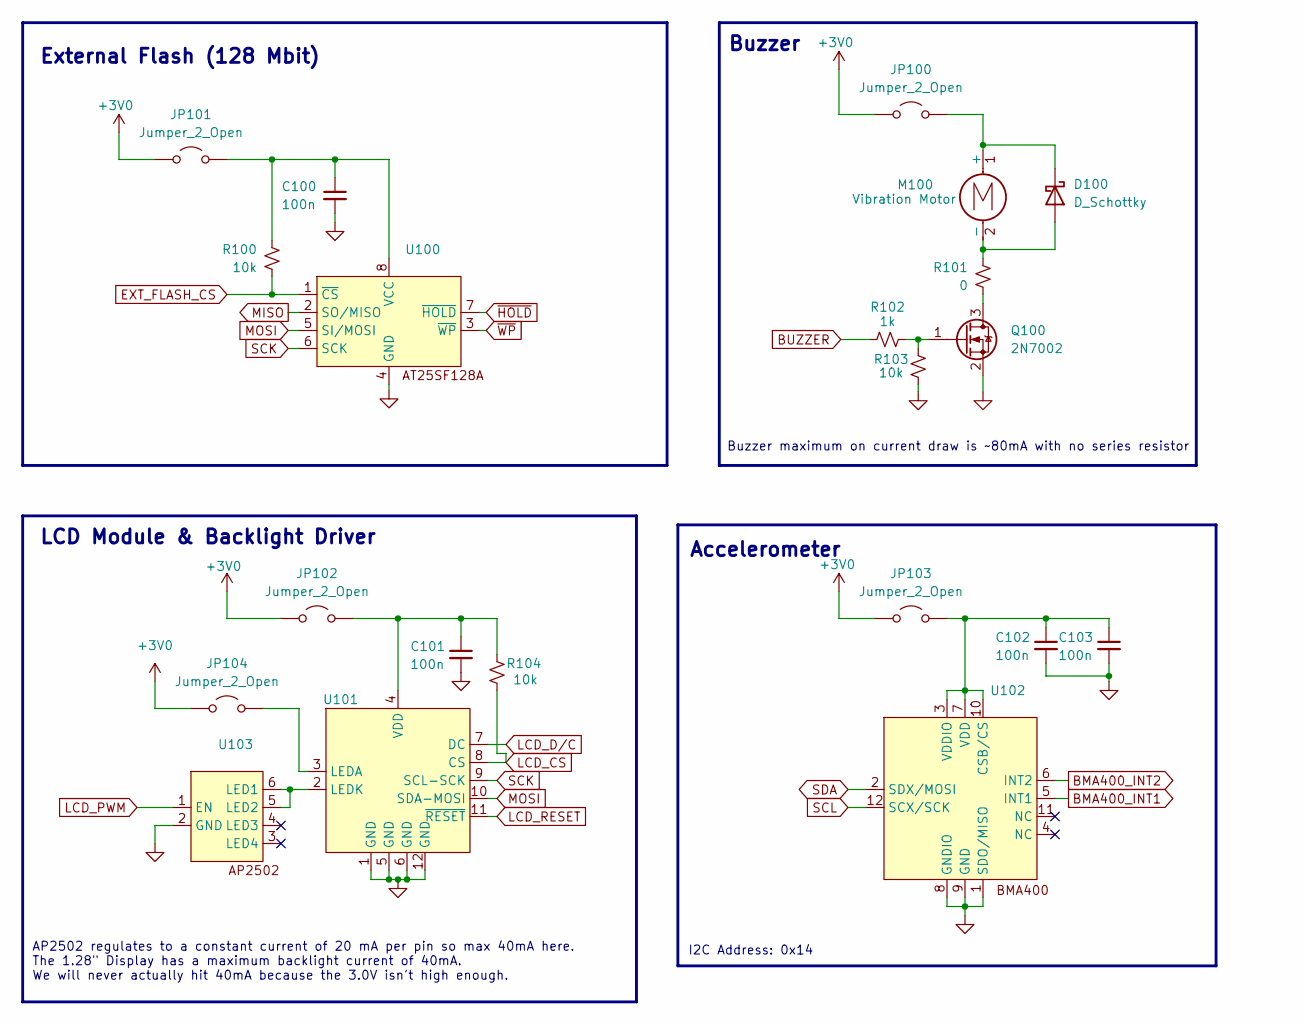
[picture p14: schematic peripherals.kicad_sch]

Parts:
C100, C101, C102, C103: 100n; C_0402_1005Metric
D100: D_Schottky; flyback_SODFL1608X70N
JP100, JP101, JP102, JP103, JP104: Jumper_2_Open; 2pinJumper_HDRV2W110P0X254_1X2_508X254X854P
M100: Vibration Motor; SMD_vibrationMotor
Q100: 2N7002; SOT-23
R100, R103, R104: 10k; R_0402_1005Metric
R101: 0; R_0603_1608Metric
R102: 1k; R_0402_1005Metric
U100: extFlash_SON127P600X500X60-9N-D
U101: 1.47_TFT_displayConnector
U102: BOSCH_LGA_12
U103: AP2502_SOT95P280X145-6N

Connections:
+3V0: JP100.1 (A), JP101.1 (A), JP102.1 (A), JP103.1 (A), JP104.1 (A); also elsewhere on the board
BMA400_INT1: U102.5 (INT1); also elsewhere on the board
BMA400_INT2: U102.6 (INT2); also elsewhere on the board
BUZZER: R102.1; also elsewhere on the board
EXT_FLASH_CS: R100.2, U100.1 (~CS); also elsewhere on the board
GND: C100.2, C101.2, C102.2, C103.2, Q100.2 (S), R103.1, U100.4 (GND), U101.1 (GND), U101.5 (GND), U101.6 (GND), U101.12 (GND), U102.1 (SDO/MISO), U102.8 (GNDIO), U102.9 (GND), U103.2 (GND); also elsewhere on the board
LCD_CS: R104.2, U101.8 (CS); also elsewhere on the board
LCD_D/C: U101.7 (DC); also elsewhere on the board
LCD_PWM: U103.1 (EN); also elsewhere on the board
LCD_RESET: U101.11 (~RESET); also elsewhere on the board
MISO: U100.2 (SO/MISO); also elsewhere on the board
MOSI: U100.5 (SI/MOSI), U101.10 (SDA-MOSI); also elsewhere on the board
unnamed: D100.2 (A), M100.2 (-), R101.1
unnamed: D100.1 (K), JP100.2 (B), M100.1 (+)
unnamed: C100.1, JP101.2 (B), R100.1, U100.8 (VCC)
unnamed: C101.1, JP102.2 (B), R104.1, U101.4 (VDD)
unnamed: C102.1, C103.1, JP103.2 (B), U102.3 (VDDIO), U102.7 (VDD), U102.10 (CSB/CS)
unnamed: JP104.2 (B), U101.3 (LEDA)
unnamed: Q100.3 (D), R101.2
unnamed: Q100.1 (G), R102.2, R103.2
unnamed: U101.2 (LEDK), U103.5 (LED2), U103.6 (LED1)
SCK: U100.6 (SCK), U101.9 (SCL-SCK); also elsewhere on the board
SCL: U102.12 (SCX/SCK); also elsewhere on the board
SDA: U102.2 (SDX/MOSI); also elsewhere on the board
~HOLD: U100.7 (~HOLD); also elsewhere on the board
~WP: U100.3 (~WP); also elsewhere on the board

Notes on the sheet:
AP2502 regulates to a constant current of 20 mA per pin so max 40mA here. The 1.28" Display has a maximum backlight current of 40mA. We will never actually hit 40mA because the 3.0V isn't high enough.
LCD Module & Backlight Driver
Buzzer
Accelerometer
Buzzer maximum on current draw is ~80mA with no series resistor
External Flash (128 Mbit)
I2C Address: 0x14
