wheuer/GeckoSmartWatch/KiCad/DevelopmentBoard/GeckoDevelopmentBoard.kicad_pcb

## KiCad design KiCad/DevelopmentBoard/GeckoDevelopmentBoard.kicad_pcb (continued)

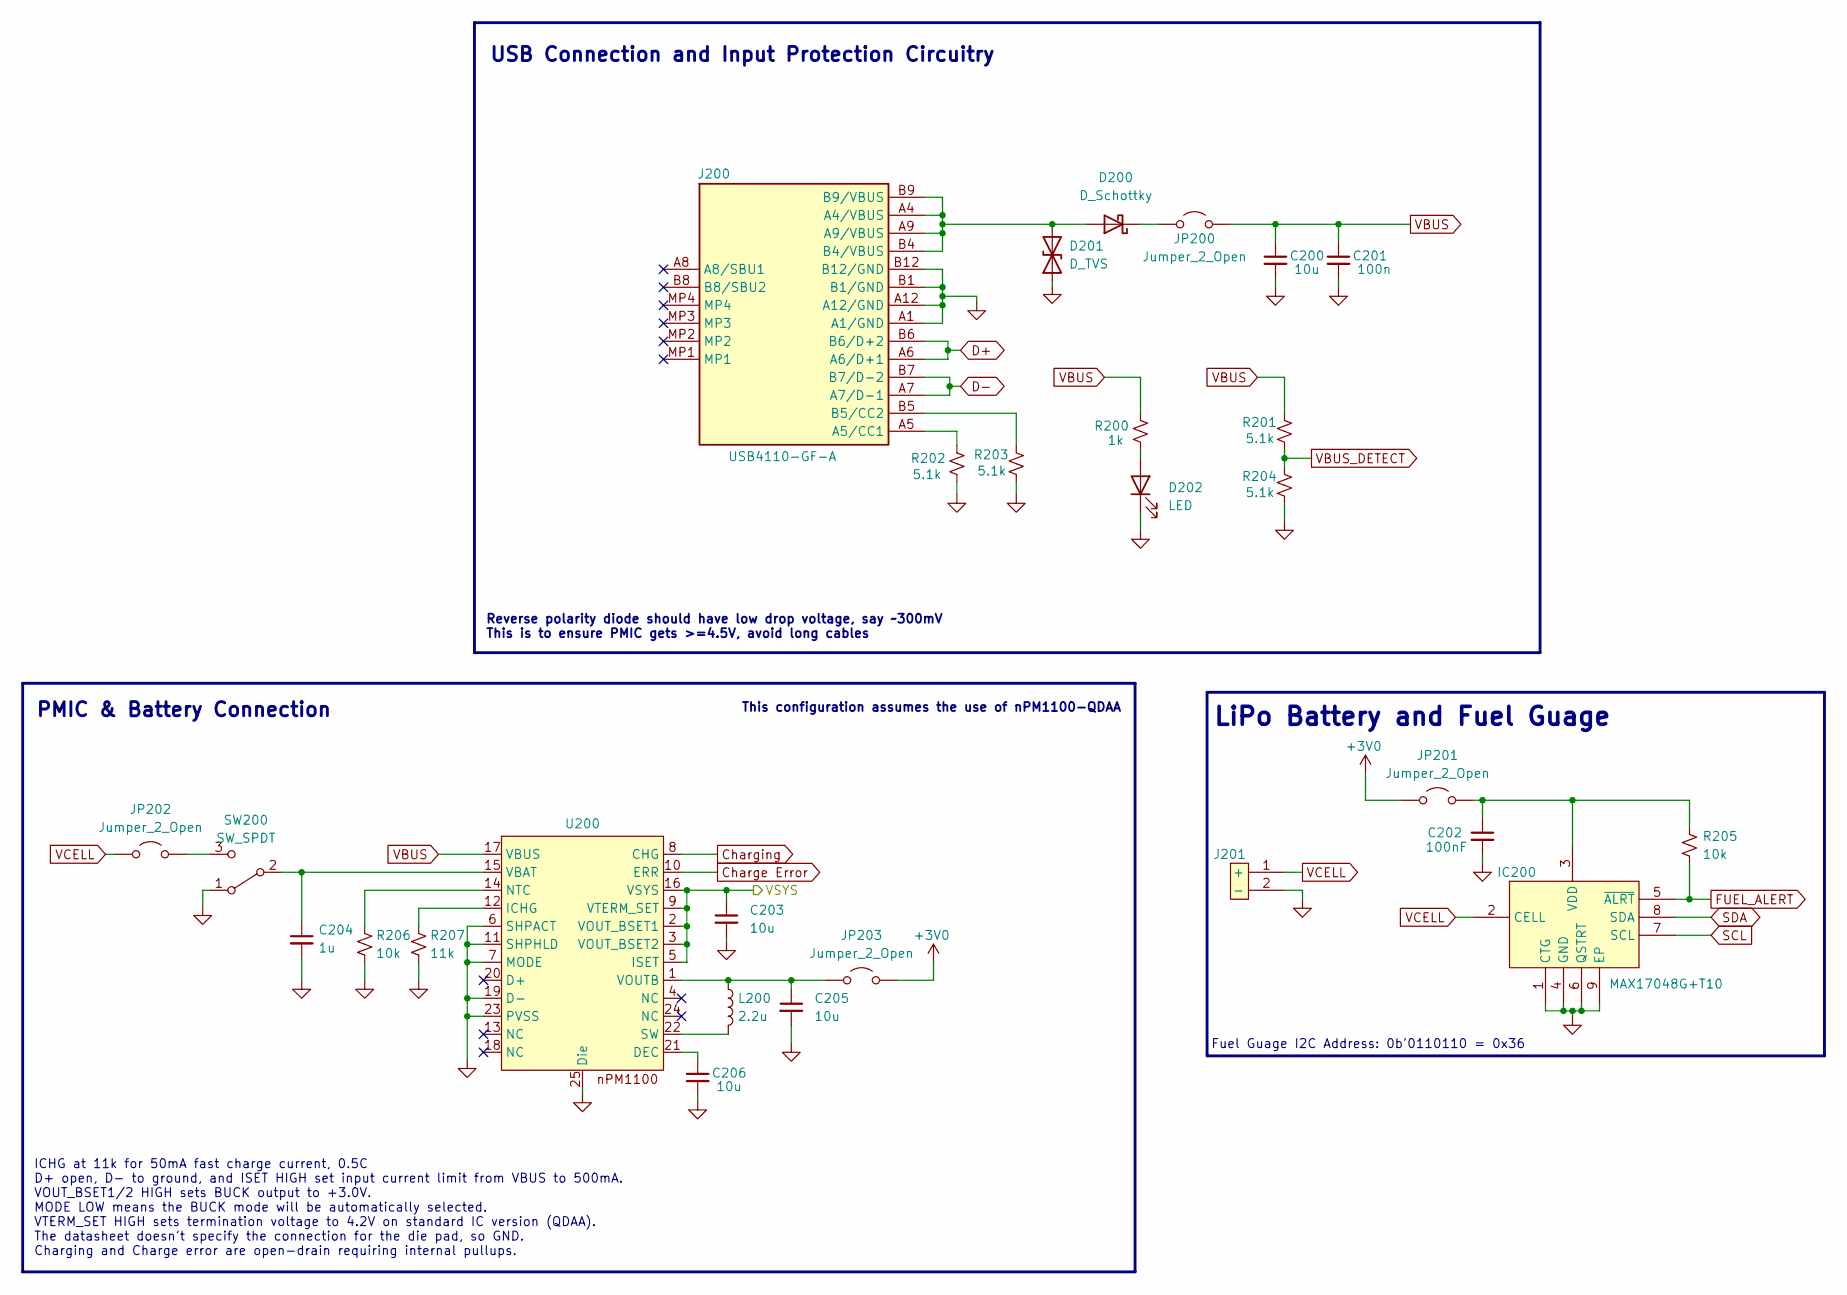
[picture p15: schematic power.kicad_sch]

Parts:
C200, C203, C205, C206: 10u; C_0402_1005Metric
C201: 100n; C_0402_1005Metric
C202: 100nF; C_0402_1005Metric
C204: 1u; C_0402_1005Metric
D200: D_Schottky; reversePolarity_SODFL3616X98N
D201: D_TVS; TVS_SOD2513X120N
D202: LED; LED_0603_1608Metric
IC200: MAX17048G+T10; MAX17048_fuelGuague; Mouser Part Number 700-MAX17048G+T10
J200: USB4110-GF-A; USB4110GFA; Mouser Part Number 640-USB4110-GF-A
J201: 1769_LiPoConnector; 1769_lipoConnector; Mouser Part Number 485-1769
JP200, JP201, JP202, JP203: Jumper_2_Open; 2pinJumper_HDRV2W110P0X254_1X2_508X254X854P
L200: 2.2u; L_0402_1005Metric
R200: 1k; R_0402_1005Metric
R201, R202, R203, R204: 5.1k; R_0402_1005Metric
R205, R206: 10k; R_0402_1005Metric
R207: 11k; R_0402_1005Metric
SW200: SW_SPDT; largerSlide_SW_JS102011JAQN
U200: nPM1100_QFN50P400X400X90-25N-D

Connections:
+3V0: JP201.1 (A), JP203.1 (A); also elsewhere on the board
/Power/VSYS: C203.1, U200.2 (VOUT_BSET1), U200.3 (VOUT_BSET2), U200.5 (ISET), U200.9 (VTERM_SET), U200.16 (VSYS)
Charge Error: U200.10 (ERR); also elsewhere on the board
Charging: U200.8 (CHG); also elsewhere on the board
D+: J200.A6 (A6/D+1), J200.B6 (B6/D+2); also elsewhere on the board
D-: J200.A7 (A7/D-1), J200.B7 (B7/D-2); also elsewhere on the board
FUEL_ALERT: IC200.5 (~ALRT), R205.1; also elsewhere on the board
GND: C200.2, C201.2, C202.2, C203.2, C204.2, C205.2, C206.2, D201.1 (A1), D202.1 (K), IC200.1 (CTG), IC200.4 (GND), IC200.6 (QSTRT), IC200.9 (EP), J200.A1 (A1/GND), J200.A12 (A12/GND), J200.B1 (B1/GND), J200.B12 (B12/GND), J201.2 (-), R202.1, R203.1, R204.1, R206.2, R207.2, SW200.1 (A), U200.6 (SHPACT), U200.7 (MODE), U200.11 (SHPHLD), U200.19 (D-), U200.23 (PVSS), U200.25 (Die); also elsewhere on the board
unnamed: D200.2 (A), D201.2 (A2), J200.A4 (A4/VBUS), J200.A9 (A9/VBUS), J200.B4 (B4/VBUS), J200.B9 (B9/VBUS)
unnamed: D200.1 (K), JP200.2 (B)
unnamed: D202.2 (A), R200.2
unnamed: C202.1, IC200.3 (VDD), JP201.2 (B), R205.2
unnamed: J200.A5 (A5/CC1), R202.2
unnamed: J200.B5 (B5/CC2), R203.2
unnamed: JP202.2 (B), SW200.3 (C)
unnamed: C205.1, JP203.2 (B), L200.1, U200.1 (VOUTB)
unnamed: C204.1, SW200.2 (B), U200.15 (VBAT)
unnamed: C206.1, U200.21 (DEC)
unnamed: R207.1, U200.12 (ICHG)
unnamed: R206.1, U200.14 (NTC)
unnamed: L200.2, U200.22 (SW)
SCL: IC200.7 (SCL); also elsewhere on the board
SDA: IC200.8 (SDA); also elsewhere on the board
VBUS: C200.1, C201.1, JP200.1 (A), R200.1, R201.2, U200.17 (VBUS); also elsewhere on the board
VBUS_DETECT: R201.1, R204.2; also elsewhere on the board
VCELL: IC200.2 (CELL), J201.1 (+), JP202.1 (A)

Notes on the sheet:
This configuration assumes the use of nPM1100-QDAA
USB Connection and Input Protection Circuitry
ICHG at 11k for 50mA fast charge current, 0.5C D+ open, D- to ground, and ISET HIGH set input current limit from VBUS to 500mA. VOUT_BSET1/2 HIGH sets BUCK output to +3.0V. MODE LOW means the BUCK mode will be automatically selected. VTERM_SET HIGH sets termination voltage to 4.2V on standard IC ve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
Fuel Guage I2C Address: 0b'0110110 = 0x36
PMIC & Battery Connection
Reverse polarity diode should have low drop voltage, say ~300mV This is to ensure PMIC gets >=4.5V, avoid long cables
LiPo Battery and Fuel Guage

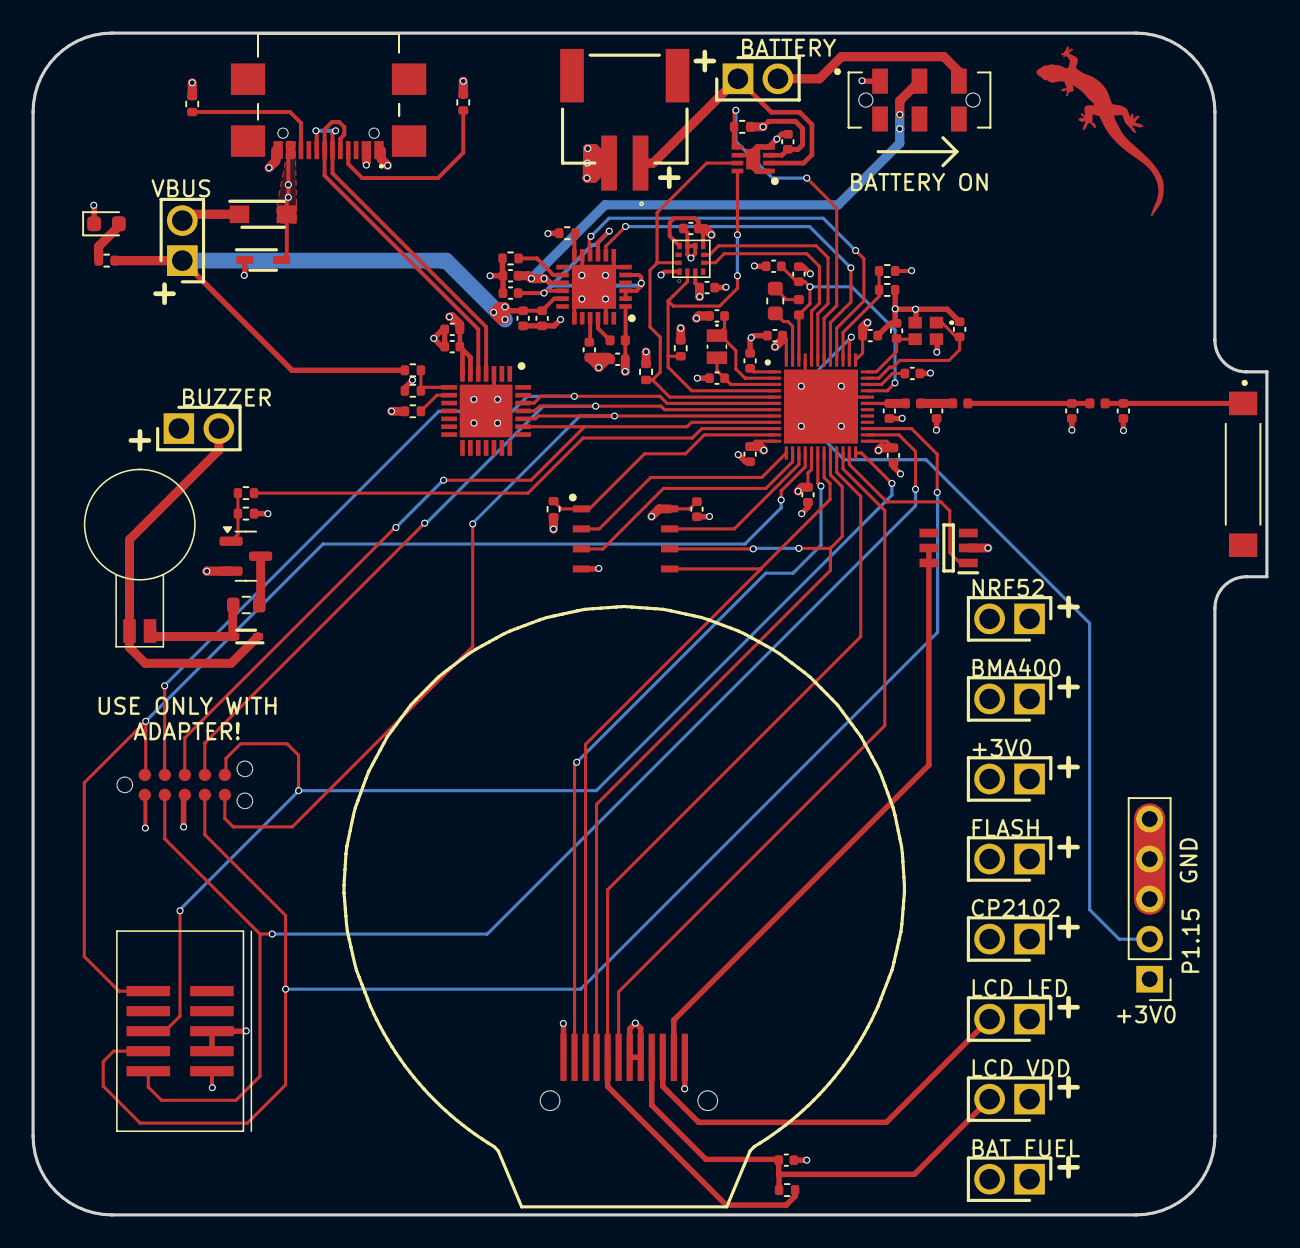
[picture p16: board GeckoDevelopmentBoard.kicad_pcb from above]

Board: 4 copper layers, 78.3 x 75.0 mm, 88 parts (0 on the bottom side), 74 nets.
