wheuer/GeckoSmartWatch/Firmware/Gecko/src/Peripherals/Display/assets.h

#ifndef __ASSETS__
#define __ASSETS__

#include <zephyr/kernel.h>
#include <lvgl.h>

// 240x240 - 115200 bytes
// extern const uint8_t Parrot[];
// extern const uint8_t watchBack[];
// extern const uint8_t lilac_breasted_roller[];
// 186x188 - 69936 bytes
// Draw at (27, 10) with large text positioned at (50, 198 )for home screen
// uint8_t coloredSlothIcon_186by188[];

// lvgl image objects are generally declared with the LV_IMG_DECLARE macro

#endif
