wheuer/GeckoSmartWatch/Firmware/Gecko/src/testing.h

#ifndef __TESTING_H__
#define __TESTING_H__

int test_BMA400(void);
int test_fuelGauge(void);
int test_ExternalFlash(void);
int test_Buzzer(void);
int test_DisplayBacklight(void);
int test_Display(void);

#endif //__TESTING_H__
