wheuer/GeckoSmartWatch/Software Tools/Display Visualizer/src/assets.h

#include <stdint.h>

#ifndef __ASSETS__
#define __ASSETS__

// 240x240 - 115200 bytes
extern uint8_t Parrot[];
extern uint8_t watchBack[];
extern uint8_t lilac_breasted_roller[];
// 186x188 - 69936 bytes
// Draw at (27, 10) with large text positioned at (50, 198 )for home screen
extern uint8_t coloredSlothIcon_186by188[];
#endif
