wheuer/GeckoSmartWatch/(commit log)

2024-07-24 [Repo Setup] Initial commit of current development progress
    [GeckoDevelopmentBoard-B_Cu.gbr, GeckoDevelopmentBoard-B_Mask.gbr, GeckoDevelopmentBoard-B_Paste.gbr, GeckoDevelopmentBoard-B_Silkscreen.gbr, GeckoDevelopmentBoard-Edge_Cuts.gbr, GeckoDevelopmentBoard-F_Cu.gbr, GeckoDevelopmentBoard-F_Mask.gbr, GeckoDevelopmentBoard-F_Paste.gbr]
2024-08-08 [Base Firmware/PCB] Implement bare system functionality and add V4 schematic and PCB
    [GeckoSmartWatch_V4_1-B_Cu.gbr, GeckoSmartWatch_V4_1-B_Mask.gbr, GeckoSmartWatch_V4_1-B_Paste.gbr, GeckoSmartWatch_V4_1-B_Silkscreen.gbr, GeckoSmartWatch_V4_1-Edge_Cuts.gbr, GeckoSmartWatch_V4_1-F_Cu.gbr, GeckoSmartWatch_V4_1-F_Mask.gbr, GeckoSmartWatch_V4_1-F_Paste.gbr]
2024-09-02 [Accelerometer/Taps] Test other BMA400 tap events
    [GeckoSmartWatch_V4_1.step]
2025-03-07 [Firmware/Android App] Major updates from local development
    [gecko_old_hardware.yml]
2025-06-30 [Android App] Make phone-watch connection more robust and add specific package filtering for notifications
